martinroger/kicad_libs/3dmodels/TL3305BF260QG.stp

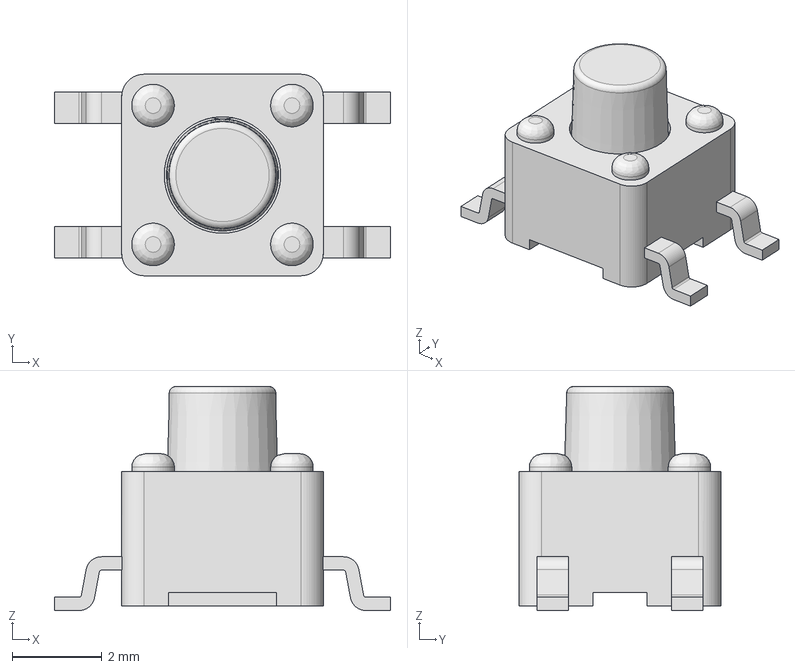
[picture p1: CAD file, 2025-06-02]
3dmodels/TL3305BF260QG.stp
7.50 x 4.50 x 5.00 mm
