martinroger/kicad_libs/3dmodels/CPDQ.step

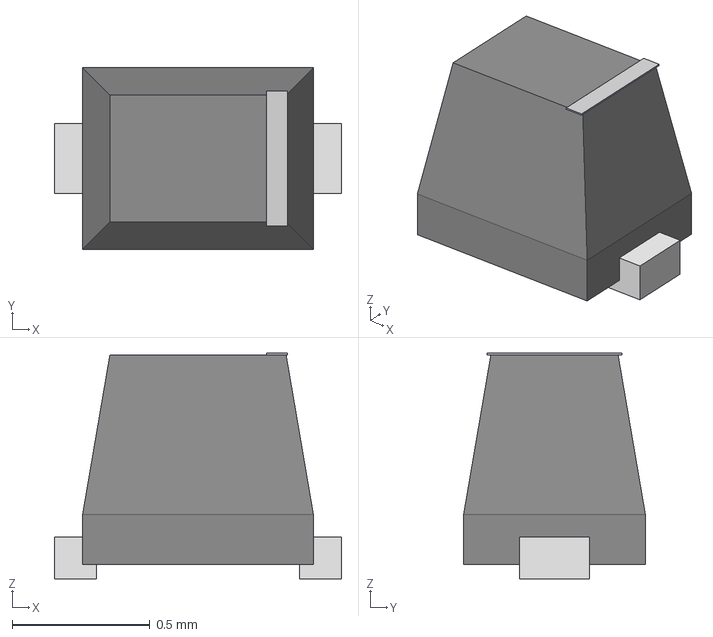
[picture p2: CAD file, 2025-03-09]
3dmodels/CPDQ.step
1.04 x 0.66 x 0.819 mm
