martinroger/kicad_libs/3dmodels/USB4105-GF-A.step

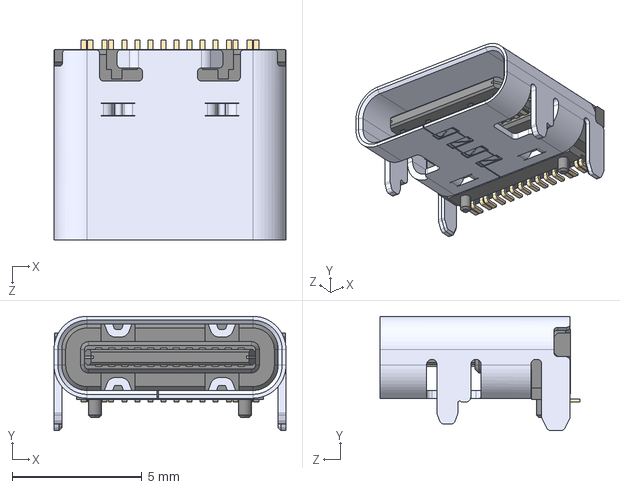
[picture p3: CAD file, 2025-03-09]
3dmodels/USB4105-GF-A.step
8.94 x 4.41 x 7.71 mm
