martinroger/kicad_libs/3dmodels/PL2303HXA.step

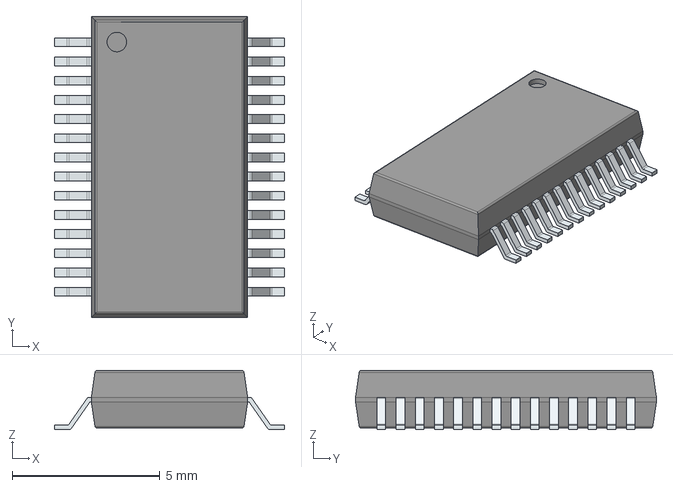
[picture p4: CAD file, 2025-03-09]
3dmodels/PL2303HXA.step
7.80 x 10.2 x 2.00 mm
PinsArrayLR
