martinroger/kicad_libs/3dmodels/PL2303SA__LF.step

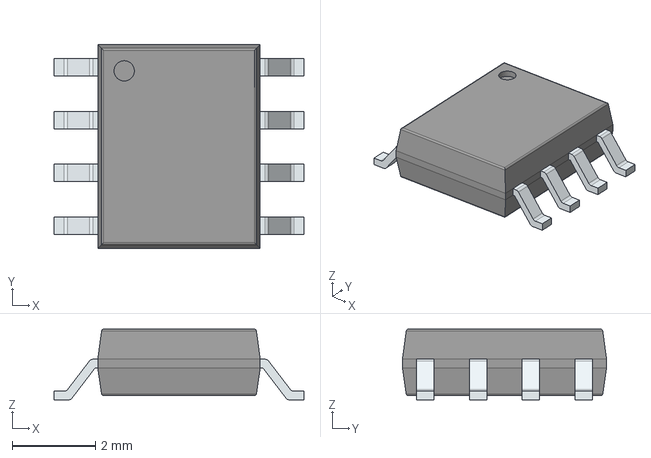
[picture p5: CAD file, 2025-03-09]
3dmodels/PL2303SA__LF.step
6.00 x 4.90 x 1.70 mm
PinsArrayLR
