martinroger/kicad_libs/3dmodels/L8050QLT1G.step

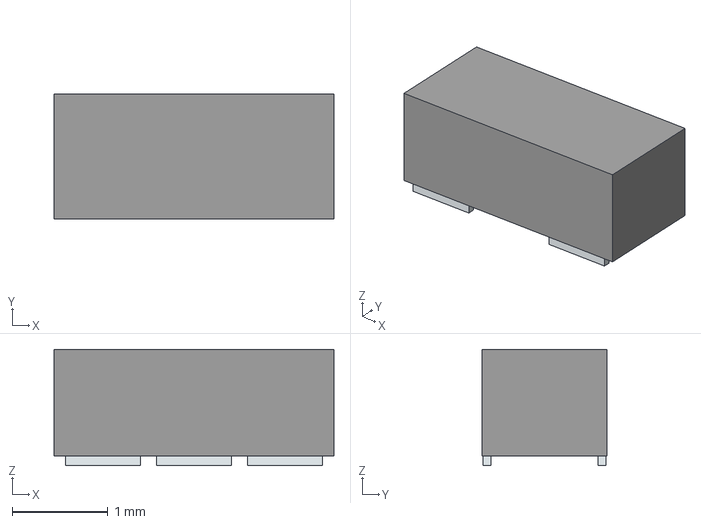
[picture p6: CAD file, 2025-03-09]
3dmodels/L8050QLT1G.step
2.92 x 1.30 x 1.21 mm
Pins
