martinroger/kicad_libs/3dmodels/MCP2515-e_ST.step

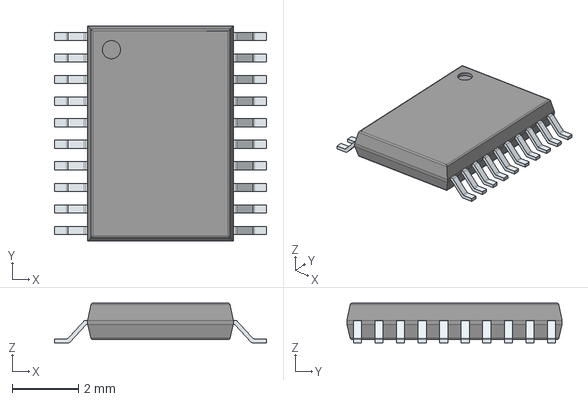
[picture p7: CAD file, 2025-03-09]
3dmodels/MCP2515-e_ST.step
6.40 x 6.50 x 1.20 mm
PinsArrayLR
