martinroger/kicad_libs/3dmodels/SJ-3524-SMT-TR-PI.step

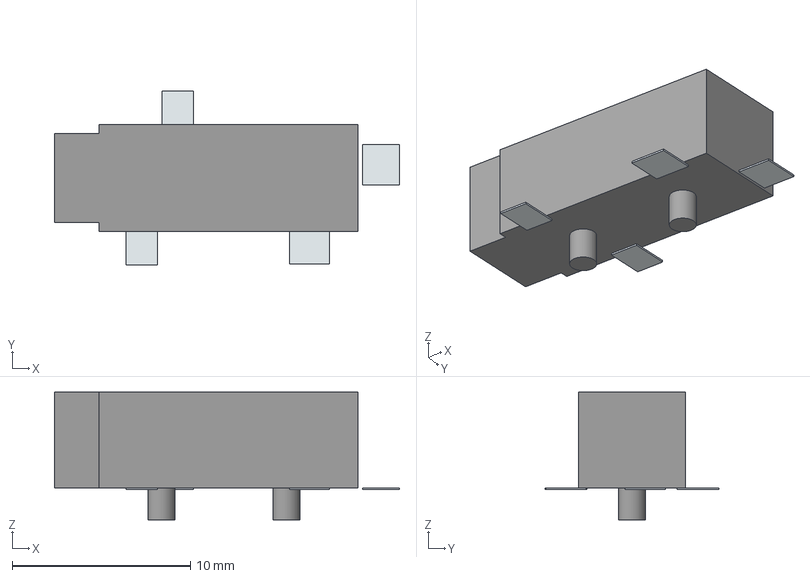
[picture p8: CAD file, 2025-03-09]
3dmodels/SJ-3524-SMT-TR-PI.step
19.3 x 9.76 x 7.17 mm
Pins
Lugs
