martinroger/kicad_libs/3dmodels/1N5819HW-7-F.step

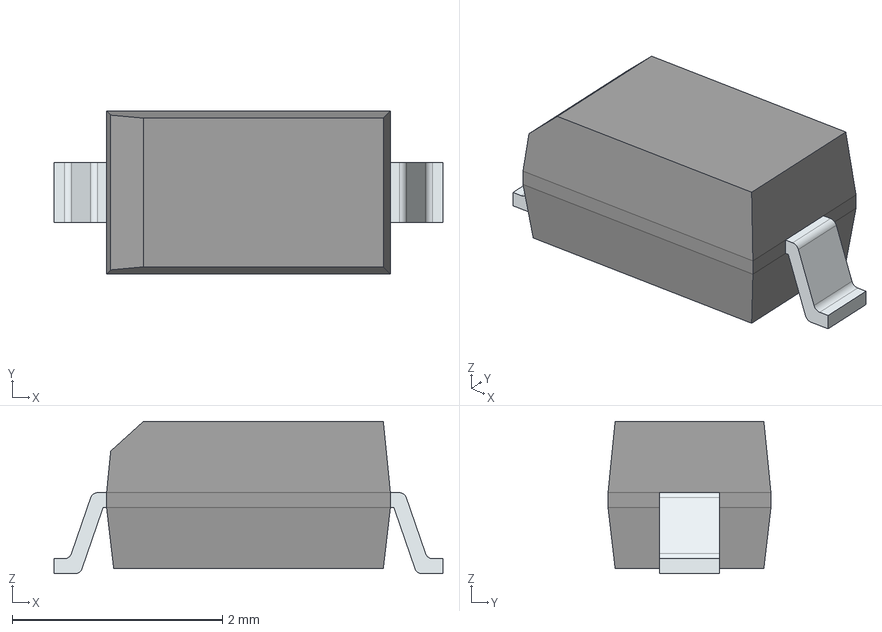
[picture p9: CAD file, 2025-03-09]
3dmodels/1N5819HW-7-F.step
3.70 x 1.55 x 1.45 mm
FilletPinL
FilletPinR
