martinroger/kicad_libs/3dmodels/SRN6045TA-150M.step

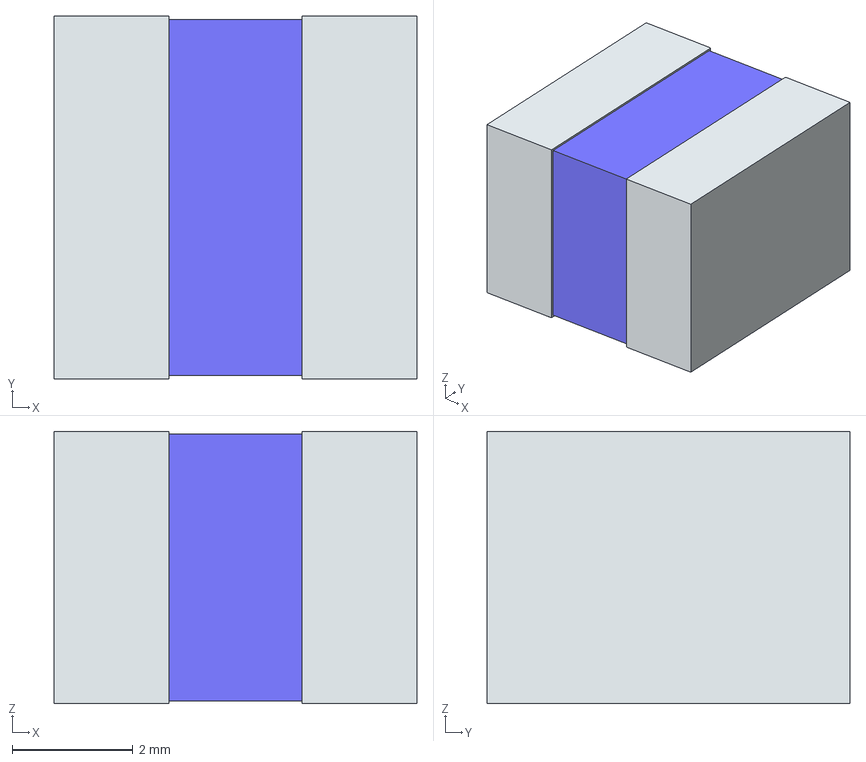
[picture p10: CAD file, 2025-03-09]
3dmodels/SRN6045TA-150M.step
6.00 x 6.00 x 4.50 mm
term1
term2
