martinroger/kicad_libs/3dmodels/TJA1044VT_3Z.step

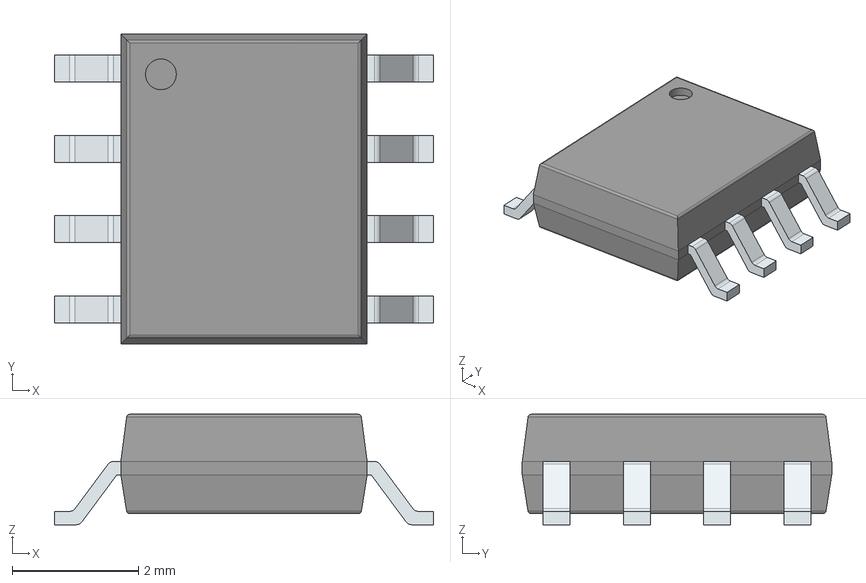
[picture p11: CAD file, 2025-03-09]
3dmodels/TJA1044VT_3Z.step
6.00 x 4.90 x 1.75 mm
PinsArrayLR
