martinroger/kicad_libs/3dmodels/SS24FL.step

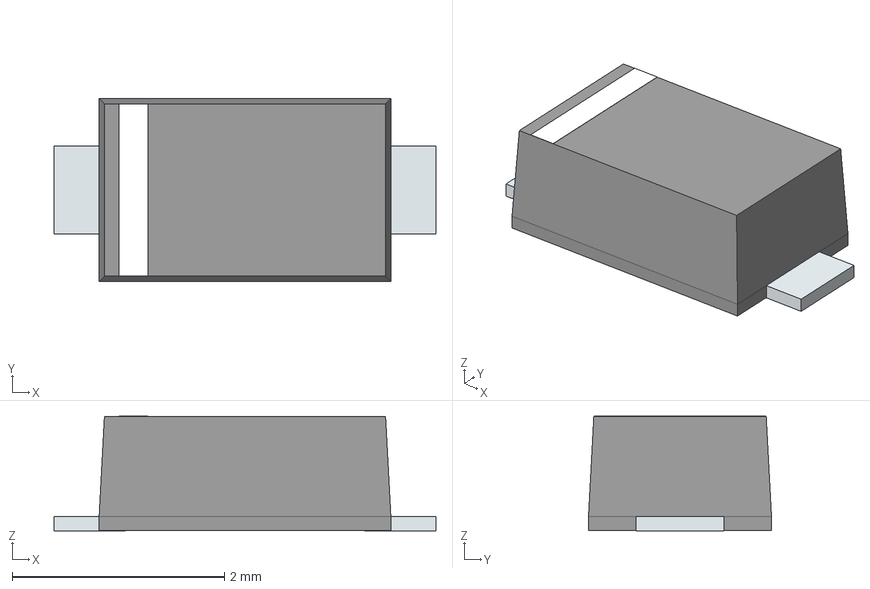
[picture p12: CAD file, 2025-03-09]
3dmodels/SS24FL.step
3.60 x 1.73 x 1.08 mm
PinKIdent
PinK
PinA
