martinroger/kicad_libs/3dmodels/PESD0402-140.step

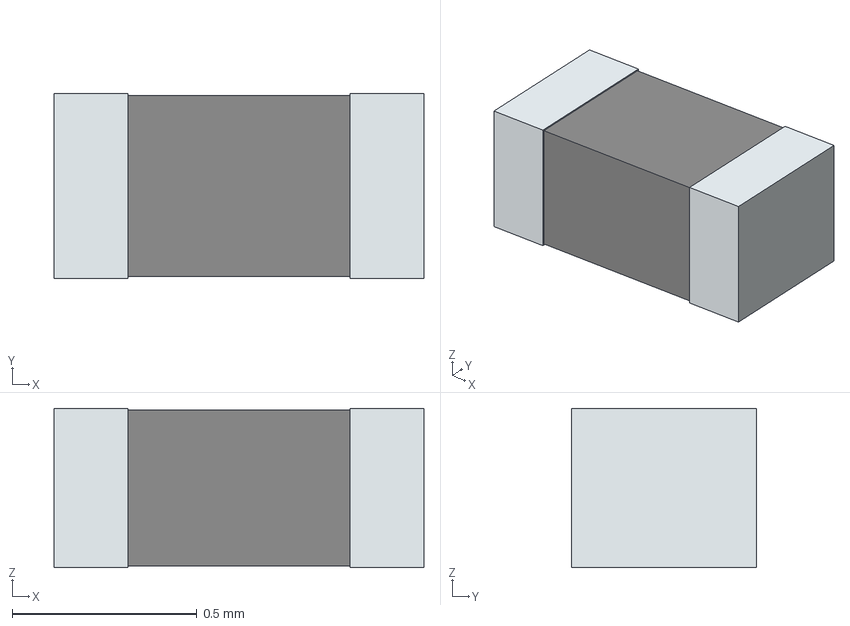
[picture p13: CAD file, 2025-03-09]
3dmodels/PESD0402-140.step
1.00 x 0.5 x 0.43 mm
term1
term2
