martinroger/kicad_libs/3dmodels/MCP2515-E_SO.step

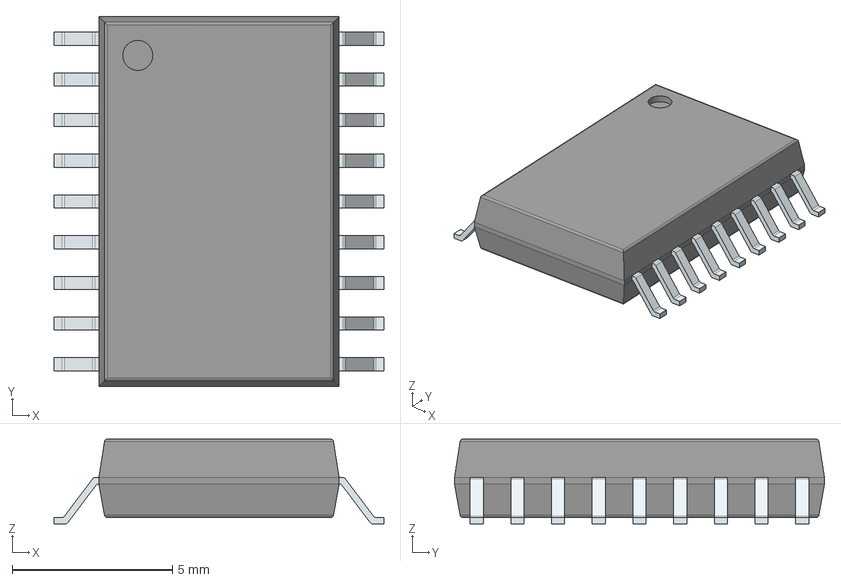
[picture p14: CAD file, 2025-03-09]
3dmodels/MCP2515-E_SO.step
10.3 x 11.6 x 2.65 mm
PinsArrayLR
