martinroger/kicad_libs/3dmodels/3678.step

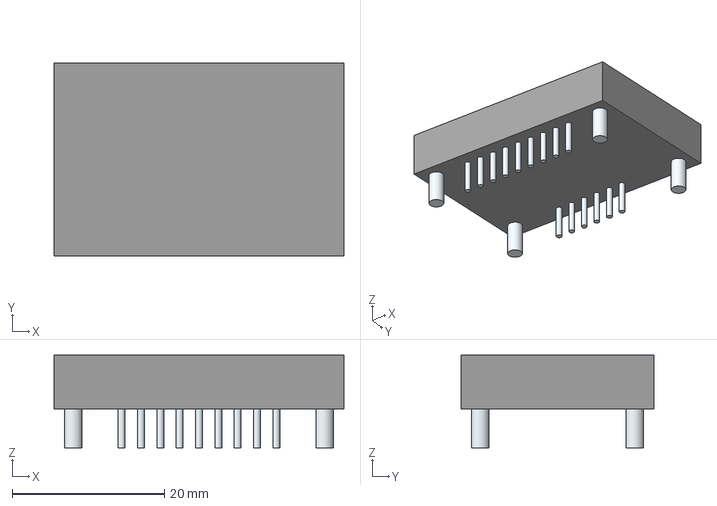
[picture p15: CAD file, 2025-03-09]
3dmodels/3678.step
38.1 x 25.4 x 12.2 mm
Leads
