martinroger/kicad_libs/3dmodels/S5GC-13-F.step

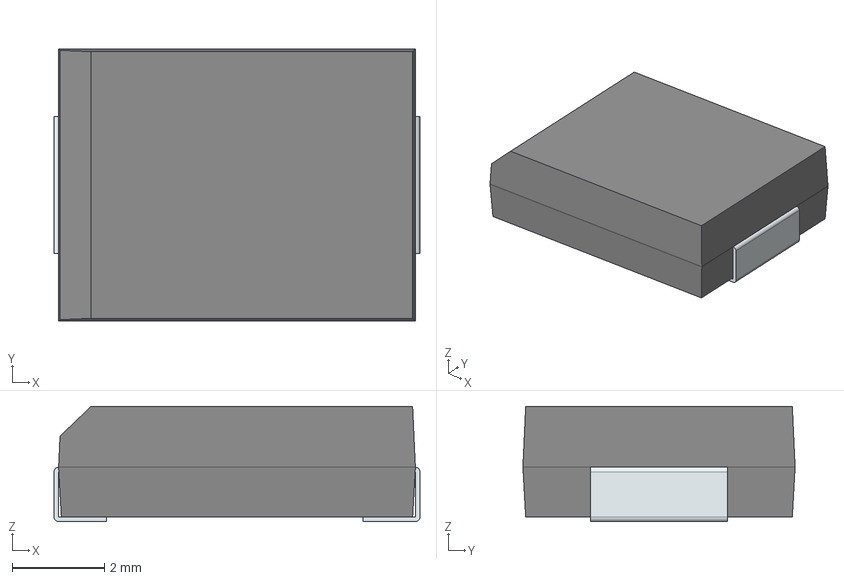
[picture p16: CAD file, 2023-04-14]
3dmodels/S5GC-13-F.step
7.94 x 5.91 x 2.50 mm
FilletPin1
FilletPin2
