martinroger/kicad_libs/3dmodels/SRP4020TA-100M.step

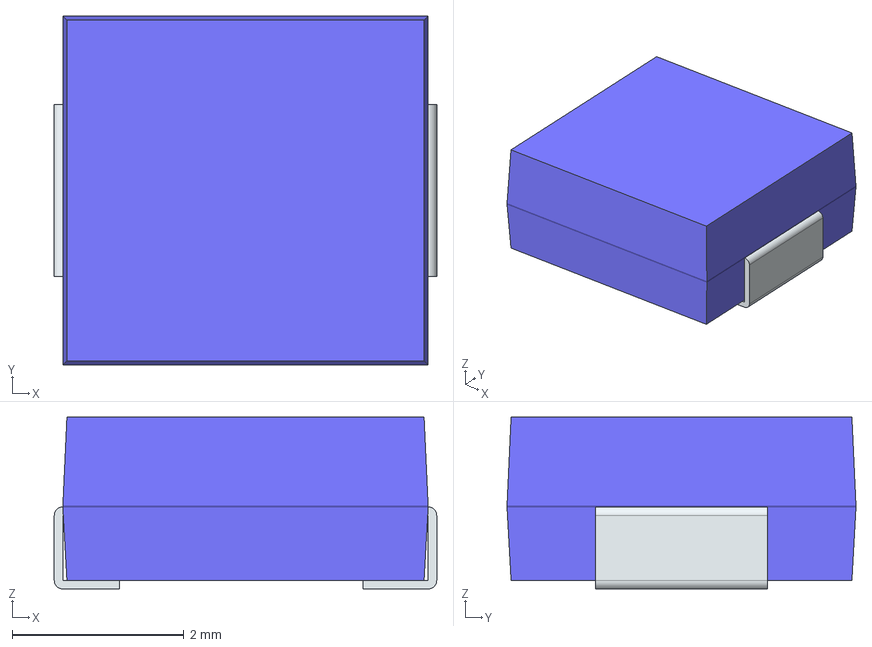
[picture p17: CAD file, 2023-04-14]
3dmodels/SRP4020TA-100M.step
4.45 x 4.06 x 2.00 mm
FilletPin1
FilletPin2
