martinroger/kicad_libs/3dmodels/CD74HC4067M96.step

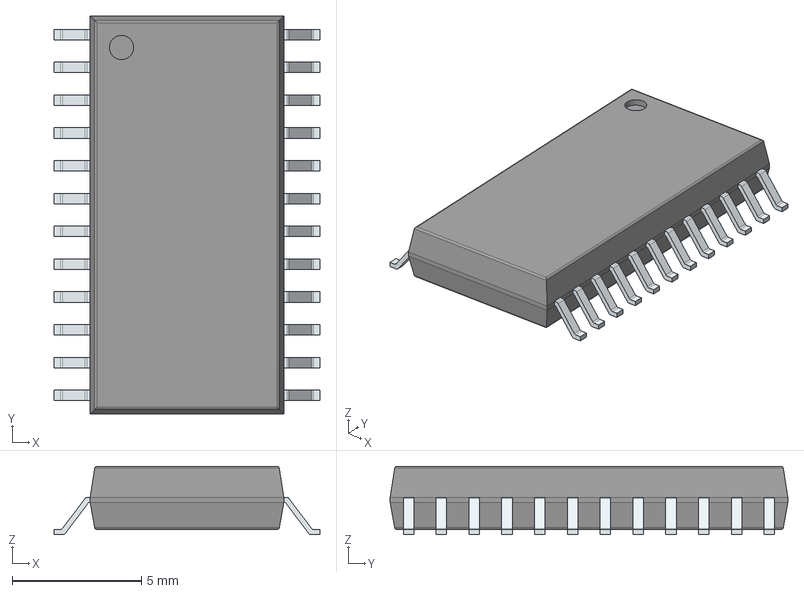
[picture p18: CAD file, 2023-04-14]
3dmodels/CD74HC4067M96.step
10.3 x 15.4 x 2.65 mm
PinsArrayLR
