martinroger/kicad_libs/3dmodels/DR127-220-R.step

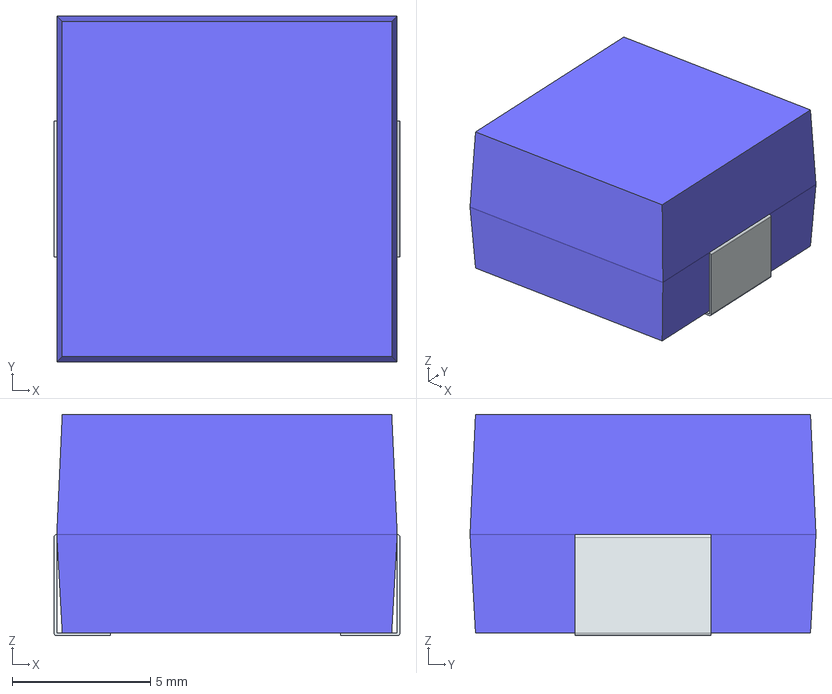
[picture p19: CAD file, 2023-04-14]
3dmodels/DR127-220-R.step
12.5 x 12.5 x 8.00 mm
FilletPin1
FilletPin2
