martinroger/kicad_libs/3dmodels/SFH6156-2T.step

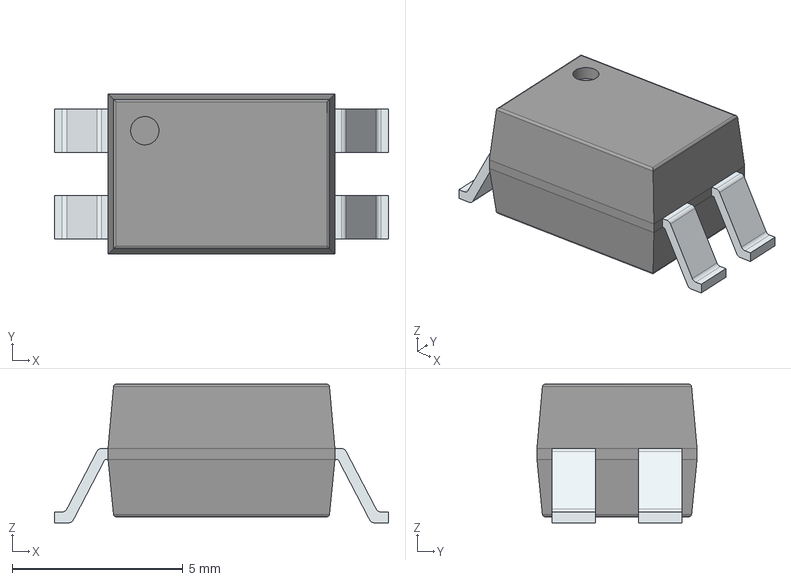
[picture p20: CAD file, 2023-04-14]
3dmodels/SFH6156-2T.step
9.78 x 4.69 x 4.06 mm
PinsArrayLR
