martinroger/kicad_libs/3dmodels/AZ1117CH-3.3TRG1.step

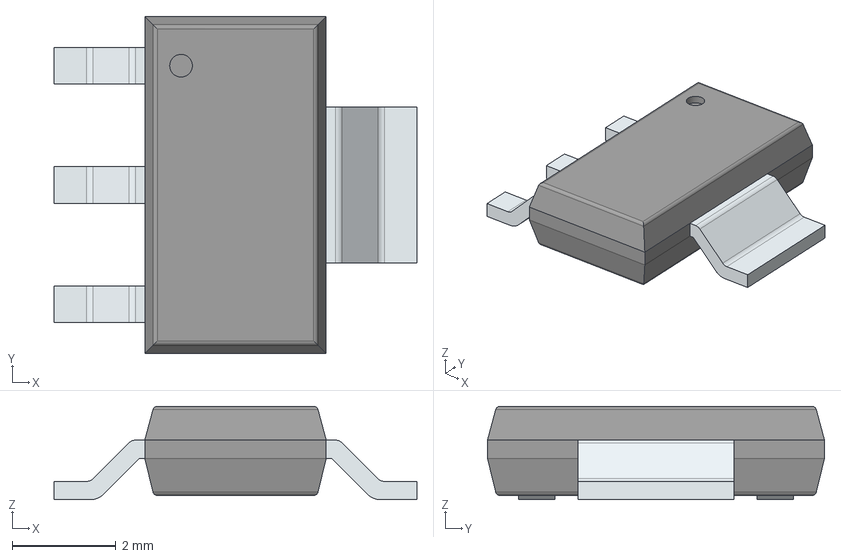
[picture p21: CAD file, 2023-04-14]
3dmodels/AZ1117CH-3.3TRG1.step
7.00 x 6.50 x 1.80 mm
PinsArrayL
FilletPinR
