martinroger/kicad_libs/3dmodels/NR111E.step

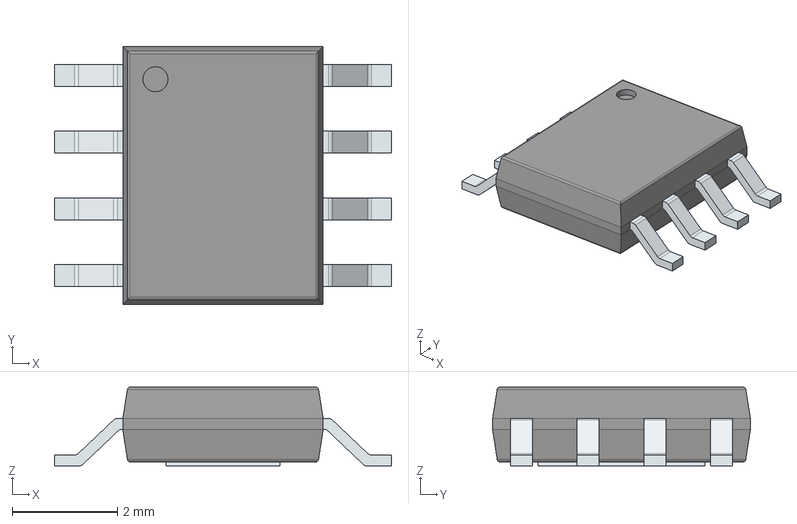
[picture p22: CAD file, 2023-04-14]
3dmodels/NR111E.step
6.41 x 4.90 x 1.50 mm
PinsArrayLR
ThermalPad
