martinroger/kicad_libs/3dmodels/SFH617A-2.step

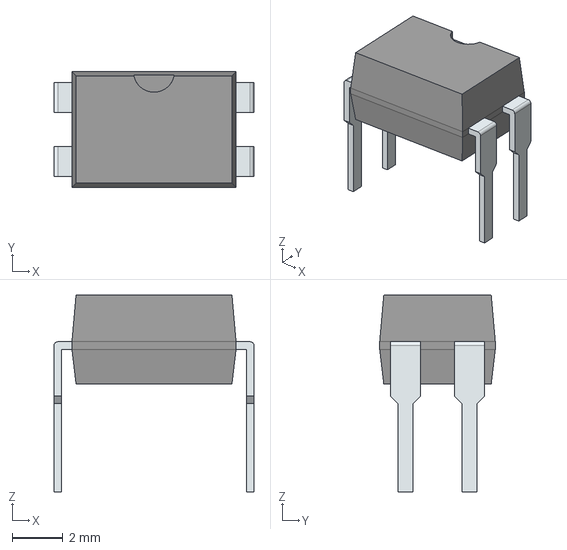
[picture p23: CAD file, 2023-04-14]
3dmodels/SFH617A-2.step
7.92 x 4.58 x 7.80 mm
PinsArrayLR
