martinroger/kicad_libs/3dmodels/MAKK2016T3R3M.step

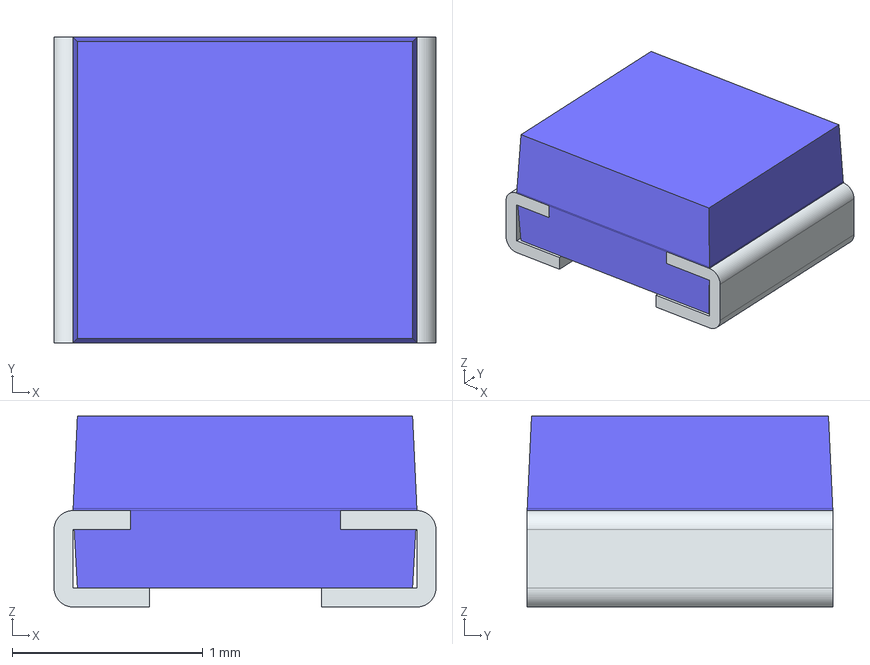
[picture p24: CAD file, 2023-04-14]
3dmodels/MAKK2016T3R3M.step
2.00 x 1.60 x 1.00 mm
FilletPin1
FilletPin2
