martinroger/kicad_libs/3dmodels/MP2322GQH-Z.step

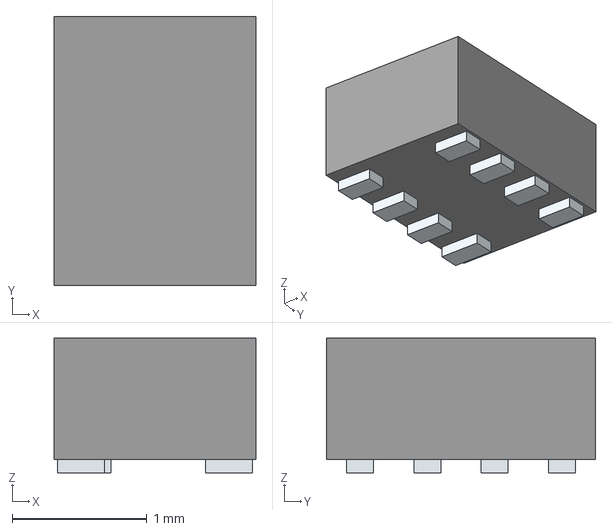
[picture p25: CAD file, 2023-04-14]
3dmodels/MP2322GQH-Z.step
1.50 x 2.00 x 1.00 mm
Pins
