martinroger/kicad_libs/3dmodels/SMCJ17A.step

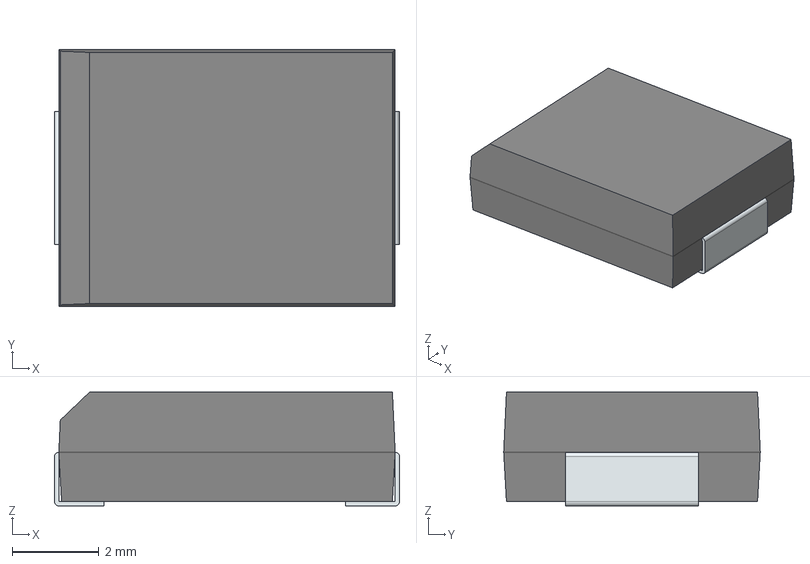
[picture p26: CAD file, 2023-04-14]
3dmodels/SMCJ17A.step
7.94 x 5.91 x 2.62 mm
FilletPin1
FilletPin2
