martinroger/kicad_libs/3dmodels/ERZV10D220.step

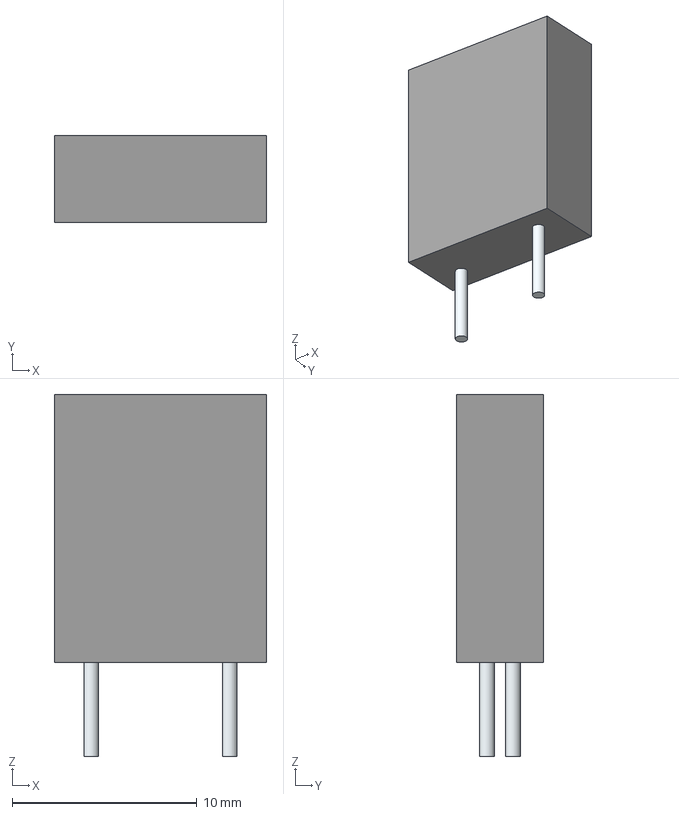
[picture p27: CAD file, 2023-04-14]
3dmodels/ERZV10D220.step
11.5 x 4.70 x 19.6 mm
Leads x 2
