martinroger/kicad_libs/3dmodels/MF-MSMF110_16-2.step

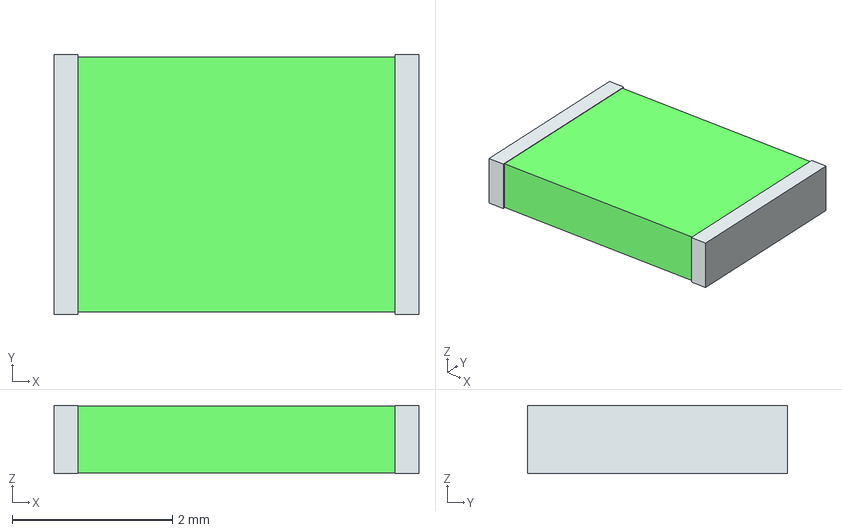
[picture p28: CAD file, 2023-04-14]
3dmodels/MF-MSMF110_16-2.step
4.55 x 3.24 x 0.85 mm
term1
term2
