martinroger/kicad_libs/(list of files, cad)

Other CAD files:
3dmodels/SP721ABG.step
3dmodels/DMN6070SSD-13.step
3dmodels/NE555DR.step
3dmodels/AP63200WU-7.step
3dmodels/MX34036UF2.step
3dmodels/SJ-3524-SMT-TR-PI.stp
