martinroger/kicad_libs/(commit log)

2023-04-14 Base commit
    [AP63200WU-7.step, AZ1117CH-3.3TRG1.step, CD74HC4067M96.step, DMN6070SSD-13.step, DR127-220-R.step, ERZV10D220.step, MAKK2016T3R3M.step, MF-MSMF110_16-2.step]
2023-04-14 Submodule Espressif kicad libraries
2025-03-09 Update parts
    [1N5819HW-7-F.step, 3678.step, L8050QLT1G.step, MCP2515-E_SO.step, MCP2515-e_ST.step, PESD0402-140.step, PL2303HXA.step, PL2303SA__LF.step]
2025-03-09 Update kicad-libraries
2025-03-09 Removing Espressif submodule
    [CPDQ.step, USB4105-GF-A.step]
2025-03-09 Moving 3D models
    [1N5819HW-7-F.step, 3678.step, AP63200WU-7.step, AZ1117CH-3.3TRG1.step, CD74HC4067M96.step, DMN6070SSD-13.step, DR127-220-R.step, ERZV10D220.step]
2025-03-10 Footprints migrations
2025-03-10 Leaning to Kicad9
2025-06-02 Additional 3D shapes
    [SJ-3524-SMT-TR-PI.stp, TL3305BF260QG.stp]
